oeps-tech/FED3-tester/PCB/tester/manufacturing/bom/FED3 tester BOM-additional.csv

# | Qty | Description | OEPSPN | MPN
1 | 18 | SPRING PROBE SLEEVE | OEPS100081 | S25-512
