oeps-tech/FED3-tester/3D/v1.0/Fed3Tester1.0.FCStd

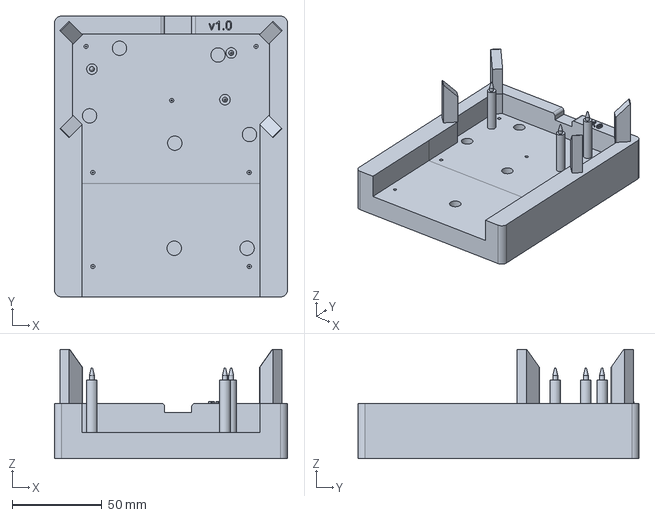
[picture p1: CAD file, 2026-05-28]
3D/v1.0/Fed3Tester1.0.FCStd
129.7 x 156.3 x 60.8 mm
