oeps-tech/FED3-tester/(list of files, cad)

Other CAD files:
3D/v1.0/manufacturing/Fed3Tester1.0-Body.stl
