oeps-tech/FED3-tester/Firmware/Fed3Tester/registers.xls

Sheet: registers
Has event. | When | Type | Array | Array Len. | Register Name | Desciption | Mask Type | Value | Name | Desciption
no |  | U16 | no |  | SWITCHES | Controls the switches like they were pressed in the physical board | bit | (1<<0) | START
 |  |  |  |  |  |  | bit | (1<<1) | PROG_OK
 |  |  |  |  |  |  | bit | (1<<2) | PROG_NOK
 |  |  |  |  |  |  | bit | (1<<3) | RGB_OK
 |  |  |  |  |  |  | bit | (1<<4) | RGB_NOK
 |  |  |  |  |  |  | bit | (1<<5) | MOTOR_OK
 |  |  |  |  |  |  | bit | (1<<6) | MOTOR_NOK
 |  |  |  |  |  |  | bit | (1<<7) | BUZZER_OK
 |  |  |  |  |  |  | bit | (1<<8) | BUZZER_NOK
yes | Every 100 ms | FLOAT | yes | 14 | READINGS | V_Vbat, V_VccRgb, V_3V3, V_LedCharge, V_LedRed, V_LedGreen, I_Vbat, SW_Start, SW_Prog, SW_Rgb, SW_Motor, SW_Buzzer, CurentState, PassFail
no |  | U16 | no |  | CONTROL | Controls internal signals | bit | (1<<0) | EN_VUSB_TO_DUT
no |  | U16 | no |  | CONTROL_SET | Controls internal signals | bit | (1<<1) | EN_3V7_TO_VBAT
no |  | U16 | no |  | CONTROL_CLEAR | Controls internal signals | bit | (1<<2) | EN_DUT_LDO_MODE
 |  |  |  |  |  |  | bit | (1<<3) | SELECT_VBAT_CURR_HIGH
 |  |  |  |  |  |  | bit | (1<<4) | EN_DUT_3V3_LDO
 |  |  |  |  |  |  | bit | (1<<5) | LED_3V3_AND_VBAT
 |  |  |  |  |  |  | bit | (1<<6) | LED_CURRENT
 |  |  |  |  |  |  | bit | (1<<7) | LED_LEDS
 |  |  |  |  |  |  | bit | (1<<8) | LED_VCC_RGB
 |  |  |  |  |  |  | bit | (1<<9) | LED_PASS
 |  |  |  |  |  |  | bit | (1<<10) | LED_FAIL
 |  |  |  |  |  |  | bit | (1<<11) | SOUND_WAIT_FOR_BUTTON
 |  |  |  |  |  |  | bit | (1<<12) | SOUND_PASS
 |  |  |  |  |  |  | bit | (1<<13) | SOUND_FAIL

Sheet: meta data
who am I: | 0
firmware major version: | 0
firmware minor version: | 1
hardware major version: | 2
hardware minor version: | 0
assembly version: | 0
device name: | Fed3Tester

Sheet: ios
Pin Name | PORT | Pin | Direction | Use Input | Out | Out default | Pull | Sense | Int. priority | Int. number | Desciption | Neg. Output
SW_START | PORTD | 0 | input |  |  |  | up | both_edges | off
SW_PROG_OK | PORTD | 1 | input |  |  |  | up | both_edges | off
SW_PROG_NOK | PORTD | 2 | input |  |  |  | up | both_edges | off
SW_MOTOR_OK | PORTD | 3 | input |  |  |  | up | both_edges | off
SW_MOTOR_NOK | PORTD | 4 | input |  |  |  | up | both_edges | off
SW_RGB_OK | PORTD | 5 | input |  |  |  | up | both_edges | off
SW_RGB_NOK | PORTD | 6 | input |  |  |  | up | both_edges | off
SW_BUZZER_OK | PORTD | 7 | input |  |  |  | up | both_edges | off
SW_BUZZER_NOK | PORTA | 0 | input |  |  |  | up | both_edges | off
LED_3V3_AND_VBAT | PORTC | 0 | output | yes | digital | 0 |  |  |  |  |  | no
LED_CURRENT | PORTC | 1 | output | yes | digital | 0 |  |  |  |  |  | no
LED_LEDS | PORTC | 2 | output | yes | digital | 0 |  |  |  |  |  | no
LED_VCC_RGB | PORTC | 3 | output | yes | digital | 0 |  |  |  |  |  | no
LED_PASS | PORTC | 5 | output | yes | digital | 0 |  |  |  |  |  | no
LED_FAIL | PORTC | 6 | output | yes | digital | 0 |  |  |  |  |  | no
EN_VUSB_TO_DUT | PORTC | 4 | output | yes | digital | 0 |  |  |  |  |  | no
BUZZER | PORTC | 7 | output | yes | digital | 0 |  |  |  |  |  | no
EN_3V7_TO_VBAT | PORTB | 0 | output | yes | digital | 0 |  |  |  |  |  | no
EN_DUT_LDO_MODE | PORTB | 1 | output | yes | digital | 0 |  |  |  |  |  | yes
SELECT_VBAT_CURR_HIGH | PORTB | 2 | output | yes | digital | 1 |  |  |  |  |  | yes
EN_DUT_3V3_LDO | PORTB | 3 | output | yes | digital | 0 |  |  |  |  |  | no

Sheet: options
Array | Type | Array | Bits type | Type | Mask Type | Direction | Use input | Pull | Sense | Int. priority | Int. number | Int. Mask | Out | Neg. Output
 |  |  |  | U8 | group_mask | input | yes | up | both_edges | low | 0 |  | digital | yes
yes | U8 | yes | bit | U16 | mask | output | no | down | rising_edge | med | 1 |  | wire_or | no
no | U16 | no | mask | U32 | bit |  |  | tristate | falling_edge | high |  |  | wire_and
 | U32 |  | group_mask | U64 |  |  |  | busholder | low_level | off |  |  | wired_or_pull
 | U64 |  |  | I8 |  |  |  |  | no_interrupt |  |  |  | wired_and_pull
 | I8 |  |  | I16
 | I16 |  |  | I32
 | I32 |  |  | I64
 | I64 |  |  | FLOAT
 | FLOAT
