oeps-tech/FED3-tester/PCB/tester/FED3 tester.kicad_pcb

## KiCad design PCB/tester/FED3 tester.kicad_pcb (2026-06-15)

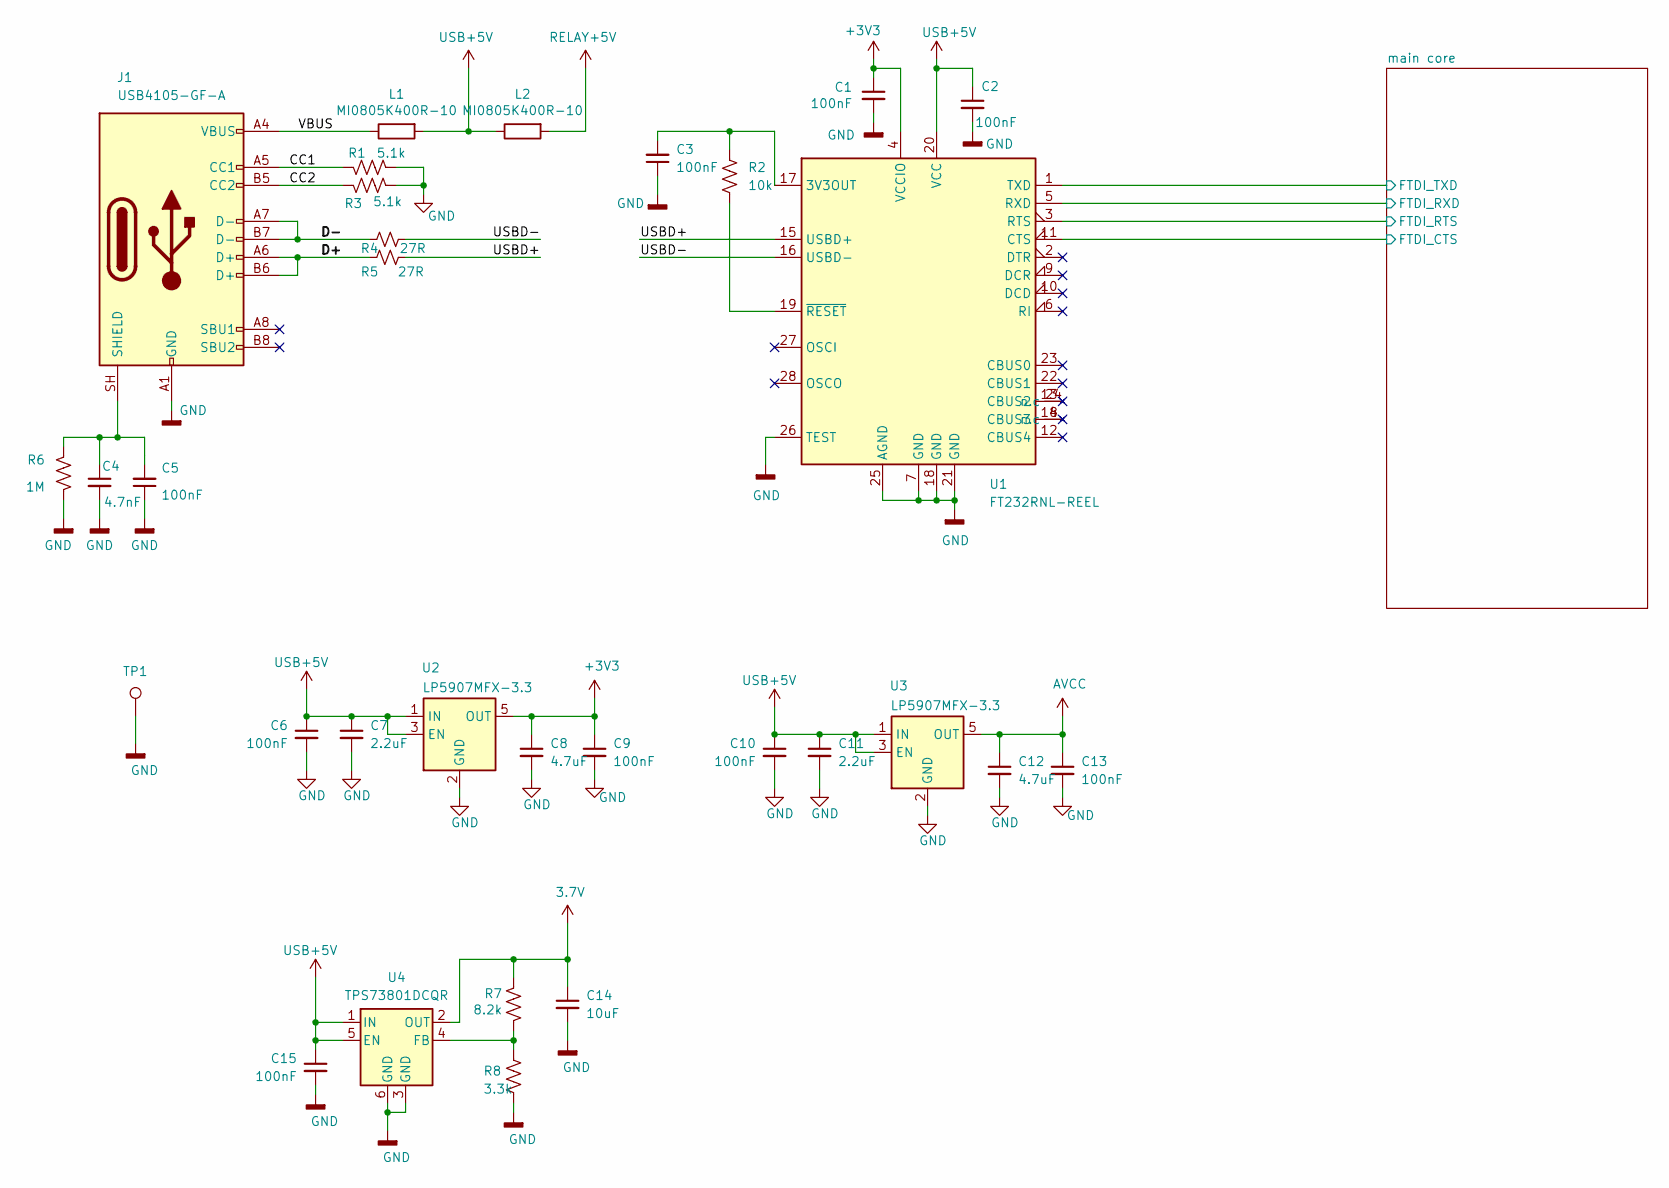
[picture p2: schematic FED3 tester.kicad_sch, FED3 Test Board]

Parts:
C1, C2, C3, C5, C6, C9, C10, C13, C15: 100nF; C_0402_1005Metric; Tolerance 10%; Voltage 50V; MPN CGA2B3X7R1H104K050BB
C4: 4.7nF; C_0402_1005Metric; Tolerance 10%; Voltage 100V; MPN 885012205084
C7, C11: 2.2uF; C_0603_1608Metric; Tolerance 10%; Voltage 25V; MPN GRM188R61E225KA12D
C8, C12: 4.7uF; C_0603_1608Metric; Tolerance 10%; Voltage 16V; MPN C1608X6S1C475K080AC
C14: 10uF; C_1206_3216Metric; Tolerance 10%; Voltage 25V; MPN GRM31CR71E106KA12L
J1: USB4105-GF-A; USB_C_Receptacle_GCT_USB4105-xx-A_16P_TopMnt_Horizontal; MPN USB4105-GF-A
L1, L2: MI0805K400R-10; R_0805_2012Metric; MPN MI0805K400R-10
R1, R3: 5.1k; R_0402_1005Metric; Tolerance 0.1%; MPN RT0402BRD075K1L
R2: 10k; R_0402_1005Metric; Tolerance 0.1%; MPN CPF0402B10KE1
R4, R5: 27R; R_0402_1005Metric; Tolerance 1%; MPN RMCF0402FT27R0
R6: 1M; R_0402_1005Metric; Tolerance 1%; MPN CRCW04021M00FKED
R7: 8.2k; R_0603_1608Metric; Tolerance 1%; MPN ERJ-3EKF8201V
R8: 3.3k; R_0402_1005Metric; Tolerance 1%; MPN ERJ-2RKF3301X
TP1: GND; PinHeader_1x01_P2.54mm_Vertical; MPN n.a
U1: FT232RNL-REEL; SSOP-28_5.3x10.2mm_P0.65mm; MPN FT232RNL-REEL
U2, U3: LP5907MFX-3.3; SOT-23-5; MPN LP5907MFX-3.3/NOPB
U4: TPS73801DCQR; SOT-223-6; MPN TPS73801DCQR

Connections:
3.7V: C14.1, R7.2, U4.2 (OUT); also elsewhere on the board
+3V3: C1.1, C8.1, C9.1, U1.4 (VCCIO), U2.5 (OUT); also elsewhere on the board
/CC1: J1.A5 (CC1), R1.1
/CC2: J1.B5 (CC2), R3.1
/D+: J1.A6 (D+), J1.B6 (D+), R5.2
/D-: J1.A7 (D-), J1.B7 (D-), R4.2
/USBD+: R5.1, U1.15 (USBD+)
/USBD-: R4.1, U1.16 (USBD-)
/VBUS: J1.A4 (VBUS), J1.A9 (VBUS), J1.B4 (VBUS), J1.B9 (VBUS), L1.1
/main core/FTDI_CTS: U1.11 (CTS); also elsewhere on the board
/main core/FTDI_RTS: U1.3 (RTS); also elsewhere on the board
/main core/FTDI_RXD: U1.5 (RXD); also elsewhere on the board
/main core/FTDI_TXD: U1.1 (TXD); also elsewhere on the board
AVCC: C12.1, C13.1, U3.5 (OUT); also elsewhere on the board
GND: C1.2, C2.2, C3.1, C4.2, C5.1, C6.2, C7.2, C8.2, C9.2, C10.2, C11.2, C12.2, C13.2, C14.2, C15.2, J1.A1 (GND), J1.A12 (GND), J1.B1 (GND), J1.B12 (GND), R1.2, R3.2, R6.1, R8.1, TP1.1 (1_1), U1.7 (GND), U1.18 (GND), U1.21 (GND), U1.25 (AGND), U1.26 (TEST), U2.2 (GND), U3.2 (GND), U4.3 (GND), U4.6 (GND); also elsewhere on the board
unnamed: C4.1, C5.2, J1.SH (SHIELD), R6.2
unnamed: C3.2, R2.1, U1.17 (3V3OUT)
unnamed: R2.2, U1.19 (~RESET)
unnamed: R7.1, R8.2, U4.4 (FB)
RELAY+5V: L2.2; also elsewhere on the board
USB+5V: C2.1, C6.1, C7.1, C10.1, C11.1, C15.1, L1.2, L2.1, U1.20 (VCC), U2.1 (IN), U2.3 (EN), U3.1 (IN), U3.3 (EN), U4.1 (IN), U4.5 (EN); also elsewhere on the board

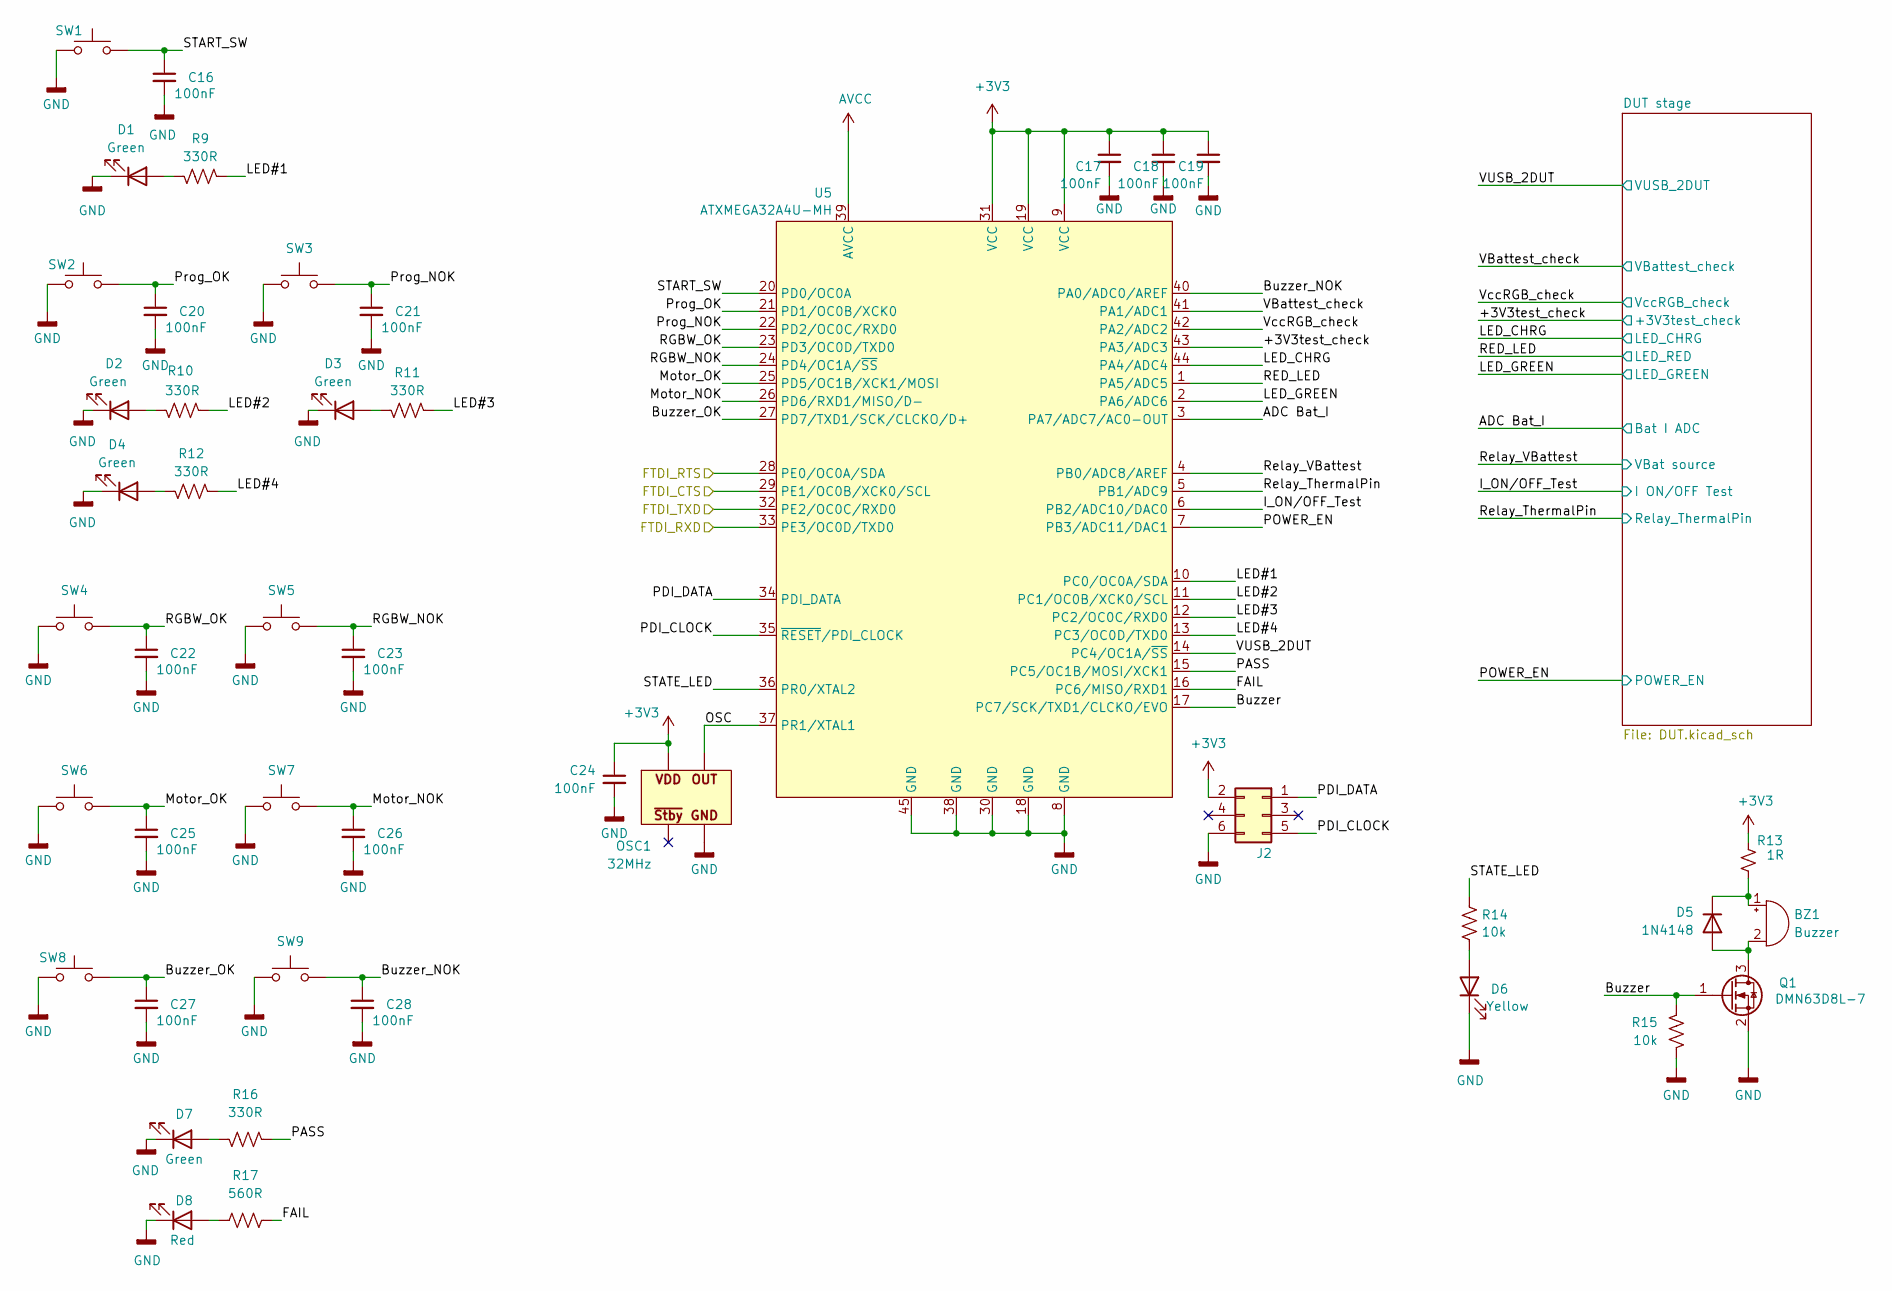
[picture p3: schematic main core.kicad_sch]

Parts:
BZ1: Buzzer; SMT-0540-T-9-R Buzzer; Voltage 3V; MPN CSS-0575A-SMT-TR
C16, C17, C18, C19, C20, C21, C22, C23, C24, C25, C26, C27, C28: 100nF; C_0402_1005Metric; Tolerance 10%; Voltage 50V; MPN CGA2B3X7R1H104K050BB
D1, D2, D3, D4, D7: Green; LED_0603_1608Metric; MPN LTST-C191KGKT
D5: 1N4148; D_SOD-123; MPN 1N4148WS-E3-18
D6: Yellow; LED_0603_1608Metric; MPN 5990040007F
D8: Red; LED_0603_1608Metric; MPN 5990010007F
J2: PR20203VBDN; PinHeader_2x03_P2.54mm_Vertical; MPN PR20203VBDN
OSC1: 32MHz; OSC; MPN DSC1001CI5-032.0000
Q1: DMN63D8L-7; SOT-23; MPN DMN63D8L-7
R9, R10, R11, R12, R16: 330R; R_0402_1005Metric; Tolerance 1%; MPN CRCW0402330RFKEDHP
R13: 1R; R_0402_1005Metric; Tolerance 1%; MPN CRCW04021R00FKEDHP
R14, R15: 10k; R_0402_1005Metric; Tolerance 0.1%; MPN CPF0402B10KE1
R17: 560R; R_0402_1005Metric; Tolerance 1%; MPN CRCW0402560RFKED
SW1, SW2, SW3, SW4, SW5, SW6, SW7, SW8, SW9: TL3305BF260QG; SW_SPST_TL3305B; MPN TL3305BF260QG
U5: ATXMEGA32A4U-MH; QFN-44-1EP_7x7mm_P0.5mm_EP5.2x5.2mm; MPN ATXMEGA32A4U-MHR

Connections:
+3V3: C17.1, C18.1, C19.1, C24.1, J2.2, OSC1.4 (VDD), R13.1, U5.9 (VCC), U5.19 (VCC), U5.31 (VCC); also elsewhere on the board
/main core/+3V3test_check: U5.43 (PA3/ADC3); also elsewhere on the board
/main core/ADC Bat_I: U5.3 (PA7/ADC7/AC0-OUT); also elsewhere on the board
/main core/Buzzer: Q1.1 (G), R15.2, U5.17 (PC7/SCK/TXD1/CLCKO/EVO)
/main core/Buzzer_NOK: C28.1, SW9.2, U5.40 (PA0/ADC0/AREF)
/main core/Buzzer_OK: C27.1, SW8.2, U5.27 (PD7/TXD1/SCK/CLCKO/D+)
/main core/FAIL: R17.2, U5.16 (PC6/MISO/RXD1)
/main core/FTDI_CTS: U5.29 (PE1/OC0B/XCK0/SCL); also elsewhere on the board
/main core/FTDI_RTS: U5.28 (PE0/OC0A/SDA); also elsewhere on the board
/main core/FTDI_RXD: U5.33 (PE3/OC0D/TXD0); also elsewhere on the board
/main core/FTDI_TXD: U5.32 (PE2/OC0C/RXD0); also elsewhere on the board
/main core/I_ON/OFF_Test: U5.6 (PB2/ADC10/DAC0); also elsewhere on the board
/main core/LED#1: R9.2, U5.10 (PC0/OC0A/SDA)
/main core/LED#2: R10.2, U5.11 (PC1/OC0B/XCK0/SCL)
/main core/LED#3: R11.2, U5.12 (PC2/OC0C/RXD0)
/main core/LED#4: R12.2, U5.13 (PC3/OC0D/TXD0)
/main core/LED_CHRG: U5.44 (PA4/ADC4); also elsewhere on the board
/main core/LED_GREEN: U5.2 (PA6/ADC6); also elsewhere on the board
/main core/Motor_NOK: C26.1, SW7.2, U5.26 (PD6/RXD1/MISO/D-)
/main core/Motor_OK: C25.1, SW6.2, U5.25 (PD5/OC1B/XCK1/MOSI)
/main core/OSC: OSC1.3 (OUT), U5.37 (PR1/XTAL1)
/main core/PASS: R16.2, U5.15 (PC5/OC1B/MOSI/XCK1)
/main core/PDI_CLOCK: J2.5, U5.35 (~RESET/PDI_CLOCK)
/main core/PDI_DATA: J2.1, U5.34 (PDI_DATA)
/main core/POWER_EN: U5.7 (PB3/ADC11/DAC1); also elsewhere on the board
/main core/Prog_NOK: C21.1, SW3.2, U5.22 (PD2/OC0C/RXD0)
/main core/Prog_OK: C20.1, SW2.2, U5.21 (PD1/OC0B/XCK0)
/main core/RED_LED: U5.1 (PA5/ADC5); also elsewhere on the board
/main core/RGBW_NOK: C23.1, SW5.2, U5.24 (PD4/OC1A/~SS)
/main core/RGBW_OK: C22.1, SW4.2, U5.23 (PD3/OC0D/TXD0)
/main core/Relay_ThermalPin: U5.5 (PB1/ADC9); also elsewhere on the board
/main core/Relay_VBattest: U5.4 (PB0/ADC8/AREF); also elsewhere on the board
/main core/START_SW: C16.1, SW1.2, U5.20 (PD0/OC0A)
/main core/STATE_LED: R14.2, U5.36 (PR0/XTAL2)
/main core/VBattest_check: U5.41 (PA1/ADC1); also elsewhere on the board
/main core/VUSB_2DUT: U5.14 (PC4/OC1A/~SS); also elsewhere on the board
/main core/VccRGB_check: U5.42 (PA2/ADC2); also elsewhere on the board
AVCC: U5.39 (AVCC); also elsewhere on the board
GND: C16.2, C17.2, C18.2, C19.2, C20.2, C21.2, C22.2, C23.2, C24.2, C25.2, C26.2, C27.2, C28.2, D1.1 (K), D2.1 (K), D3.1 (K), D4.1 (K), D6.1 (K), D7.1 (K), D8.1 (K), J2.6, OSC1.2 (GND), Q1.2 (S), R15.1, SW1.1, SW2.1, SW3.1, SW4.1, SW5.1, SW6.1, SW7.1, SW8.1, SW9.1, U5.8 (GND), U5.18 (GND), U5.30 (GND), U5.38 (GND), U5.45 (GND); also elsewhere on the board
unnamed: BZ1.1 (+), D5.1 (K), R13.2
unnamed: BZ1.2 (-), D5.2 (A), Q1.3 (D)
unnamed: D1.2 (A), R9.1
unnamed: D2.2 (A), R10.1
unnamed: D3.2 (A), R11.1
unnamed: D4.2 (A), R12.1
unnamed: D6.2 (A), R14.1
unnamed: D7.2 (A), R16.1
unnamed: D8.2 (A), R17.1

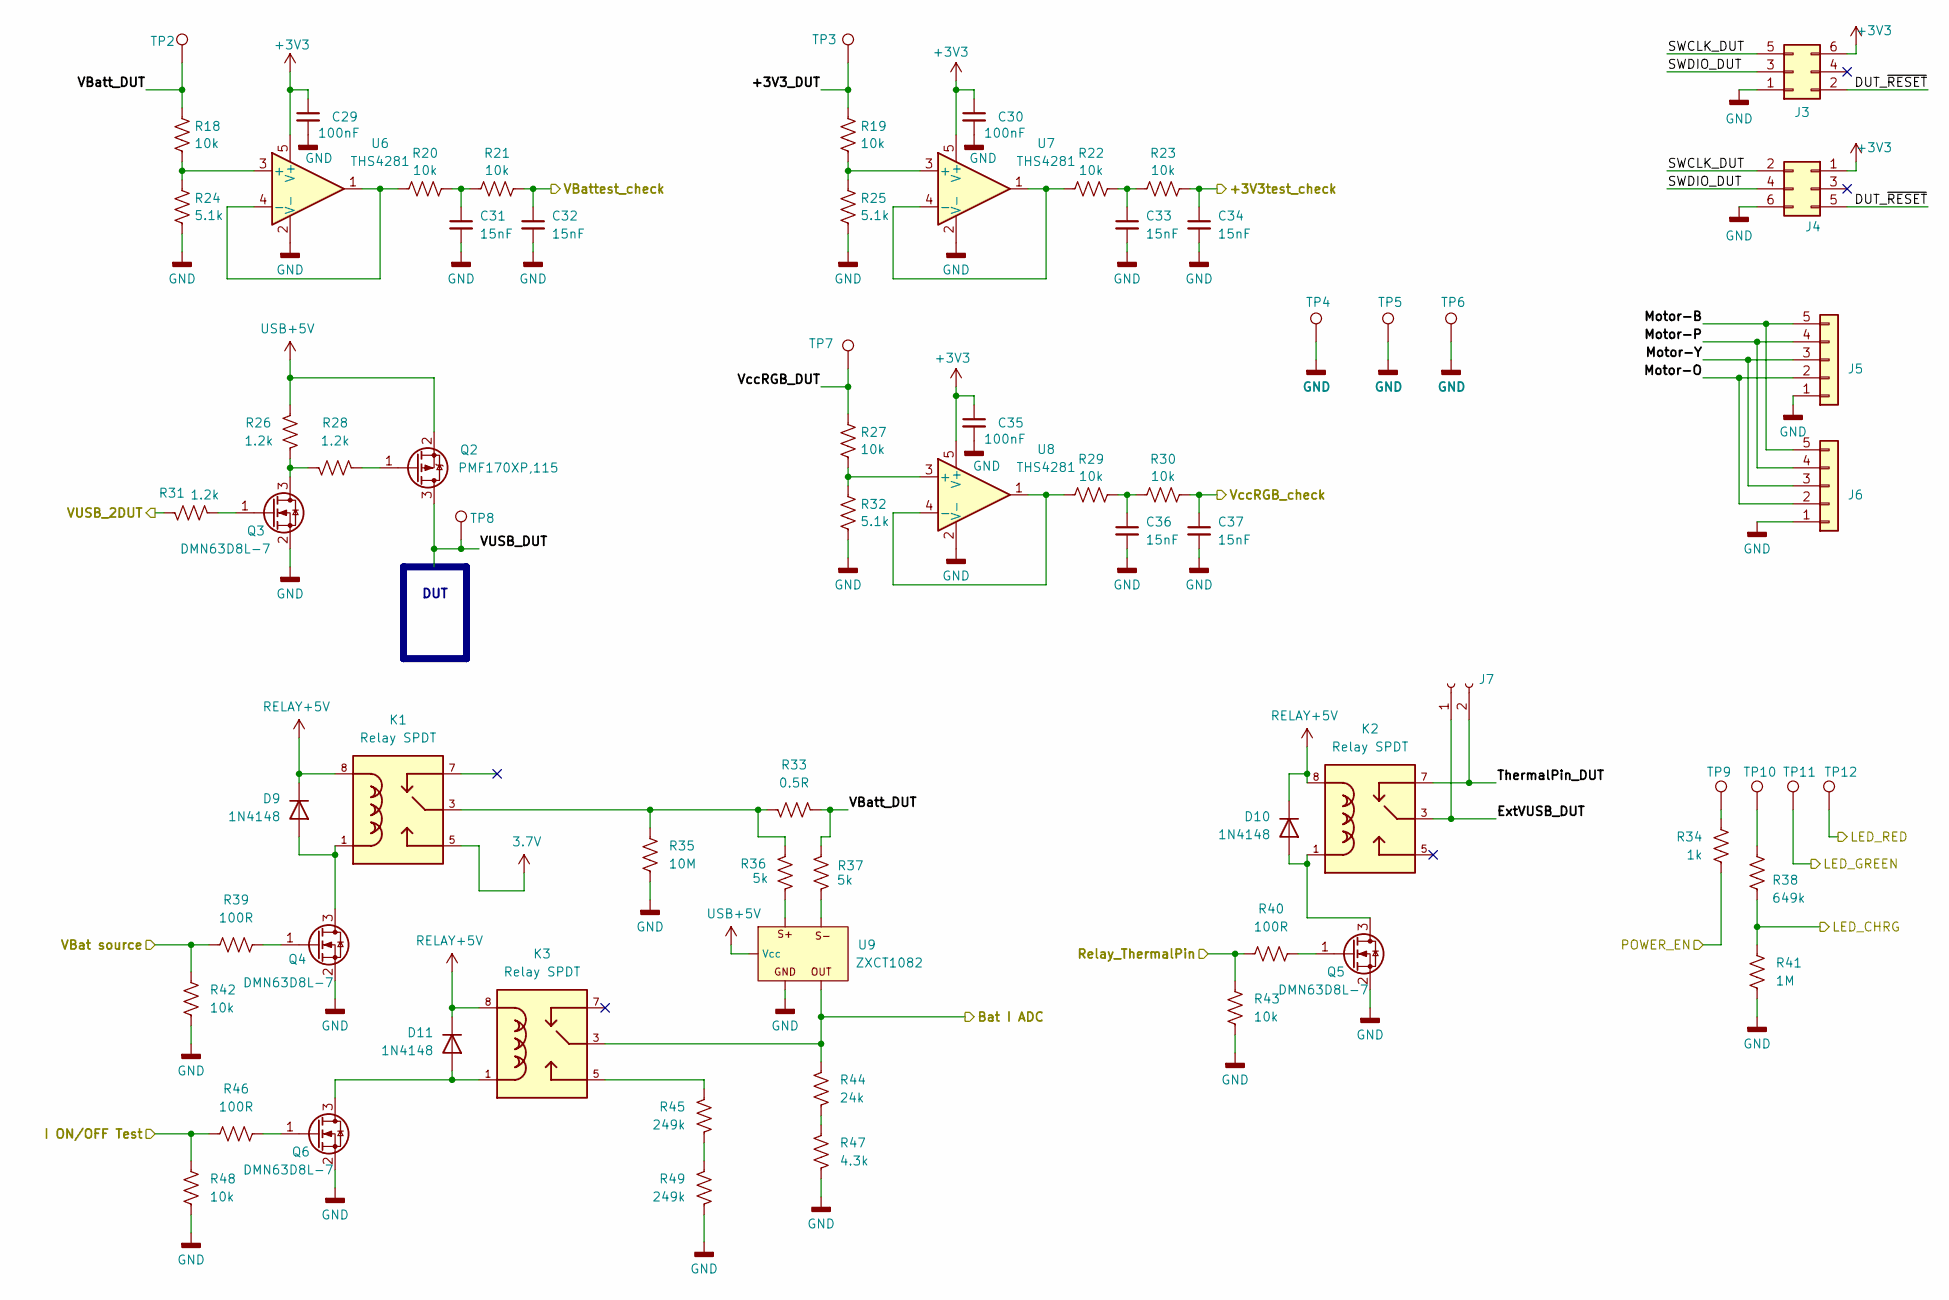
[picture p4: schematic DUT.kicad_sch]

Parts:
C29, C30, C35: 100nF; C_0402_1005Metric; Tolerance 10%; Voltage 50V; MPN CGA2B3X7R1H104K050BB
C31, C32, C33, C34, C36, C37: 15nF; C_0402_1005Metric; Tolerance 10%; Voltage 35V; MPN CGA2B3X7R1V153K050BB
D9, D10, D11: 1N4148; D_SOD-123; MPN 1N4148WS-E3-18
J3: 6pin_hd; PinHeader_2x03_to Probes; MPN n.a
J4: 61300621021; PinHeader_2x03_P2.54mm_Horizontal; MPN 61300621021
J5: PPTC051LFBN-RC; PinSocket_1x05_P2.54mm_Vertical; MPN PPTC051LFBN-RC
J6: 61300511021; PinSocket_1x05_P2.54mm_Horizontal; MPN 61300511021
J7: PPTC021LFBN-RC; PinSocket_1x02_P2.54mm_Vertical; MPN PPTC021LFBN-RC
K1, K2, K3: Relay SPDT; RELAY_1462042-8; MPN 1462042-8
Q2: PMF170XP,115; SOT-323_SC-70; MPN PMF170XP,115
Q3, Q4, Q5, Q6: DMN63D8L-7; SOT-23; MPN DMN63D8L-7
R18, R19, R20, R21, R22, R23, R27, R29, R30, R42, R43, R48: 10k; R_0402_1005Metric; Tolerance 0.1%; MPN CPF0402B10KE1
R24, R25, R32: 5.1k; R_0402_1005Metric; Tolerance 0.1%; MPN RT0402BRD075K1L
R26, R28, R31: 1.2k; R_0402_1005Metric; Tolerance 0.1%; MPN ERA-2AEB122X
R33: 0.5R; R_0805_2012Metric; Tolerance 1%; MPN RL1220S-R50-F
R34: 1k; R_0402_1005Metric; Tolerance 1%; MPN CRCW04021K00FKED
R35: 10M; R_0402_1005Metric; Tolerance 1%; MPN CRCW040210M0FKED
R36, R37: 5k; R_0402_1005Metric; Tolerance 0.1%; MPN PNM0402E5001BST1
R38: 649k; R_0402_1005Metric; Tolerance 1%; MPN ERJ-2RKF6493X
R39, R40, R46: 100R; R_0402_1005Metric; Tolerance 1%; MPN RCS0402100RFKED
R41: 1M; R_0402_1005Metric; Tolerance 1%; MPN CRCW04021M00FKED
R44: 24k; R_0402_1005Metric; Tolerance 1%; MPN ERJ-2RKF2402X
R45, R49: 249k; R_0402_1005Metric; Tolerance 1%; MPN RMCF0402FT249K
R47: 4.3k; R_0603_1608Metric; Tolerance 5%; MPN ERJ-3GEYJ432V
TP2: VBattest; Pin_D1.75mm; MPN n.a
TP3: +3V3test; Pin_D1.75mm; MPN n.a
TP4, TP5, TP6, TP9, TP10, TP11, TP12: GND; Pin_D1.75mm; MPN n.a
TP7: VccRGB; Pin_D1.75mm; MPN n.a
TP8: VUSBtest; Pin_D1.75mm; MPN n.a
U6, U7, U8: THS4281; SOT-23-5; MPN THS4281DBVT
U9: ZXCT1082; SOT-23-5; MPN ZXCT1082QE5TA

Connections:
3.7V: K1.5; also elsewhere on the board
+3V3: C29.1, C30.1, C35.1, J3.6, J4.1, U6.5 (V+), U7.5 (V+), U8.5 (V+); also elsewhere on the board
/main core/+3V3test_check: C34.1, R23.2; also elsewhere on the board
/main core/ADC Bat_I: K3.3, R44.1, U9.1 (OUT); also elsewhere on the board
/main core/DUT stage/+3V3_DUT: R19.2, TP3.1 (1_1)
/main core/DUT stage/DUT_~RESET: J3.2, J4.5
/main core/DUT stage/ExtVUSB_DUT: J7.1, K2.3
/main core/DUT stage/Motor-B: J5.5, J6.5
/main core/DUT stage/Motor-O: J5.2, J6.2
/main core/DUT stage/Motor-P: J5.4, J6.4
/main core/DUT stage/Motor-Y: J5.3, J6.3
/main core/DUT stage/SWCLK_DUT: J3.5, J4.2
/main core/DUT stage/SWDIO_DUT: J3.3, J4.4
/main core/DUT stage/ThermalPin_DUT: J7.2, K2.7
/main core/DUT stage/VBatt_DUT: R18.2, R33.2, R37.2, TP2.1 (1_1)
/main core/DUT stage/VUSB_DUT: Q2.3 (D), TP8.1 (1_1)
/main core/DUT stage/VccRGB_DUT: R27.2, TP7.1 (1_1)
/main core/I_ON/OFF_Test: R46.1, R48.2; also elsewhere on the board
/main core/LED_CHRG: R38.1, R41.2; also elsewhere on the board
/main core/LED_GREEN: TP11.1 (1_1); also elsewhere on the board
/main core/POWER_EN: R34.1; also elsewhere on the board
/main core/RED_LED: TP12.1 (1_1); also elsewhere on the board
/main core/Relay_ThermalPin: R40.1, R43.2; also elsewhere on the board
/main core/Relay_VBattest: R39.1, R42.2; also elsewhere on the board
/main core/VBattest_check: C32.1, R21.2; also elsewhere on the board
/main core/VUSB_2DUT: R31.2; also elsewhere on the board
/main core/VccRGB_check: C37.1, R30.2; also elsewhere on the board
GND: C29.2, C30.2, C31.2, C32.2, C33.2, C34.2, C35.2, C36.2, C37.2, J3.1, J4.6, J5.1, J6.1, Q3.2 (S), Q4.2 (S), Q5.2 (S), Q6.2 (S), R24.1, R25.1, R32.1, R35.1, R41.1, R42.1, R43.1, R47.2, R48.1, R49.1, TP4.1 (1_1), TP5.1 (1_1), TP6.1 (1_1), U6.2 (V-), U7.2 (V-), U8.2 (V-), U9.2 (GND); also elsewhere on the board
unnamed: C31.1, R20.2, R21.1
unnamed: C33.1, R22.2, R23.1
unnamed: C36.1, R29.2, R30.1
unnamed: D9.2 (A), K1.1, Q4.3 (D)
unnamed: D10.2 (A), K2.1, Q5.3 (D)
unnamed: D11.2 (A), K3.1, Q6.3 (D)
unnamed: K1.3, R33.1, R35.2, R36.2
unnamed: K3.5, R45.2
unnamed: Q2.1 (G), R28.2
unnamed: Q3.3 (D), R26.1, R28.1
unnamed: Q3.1 (G), R31.1
unnamed: Q4.1 (G), R39.2
unnamed: Q5.1 (G), R40.2
unnamed: Q6.1 (G), R46.2
unnamed: R34.2, TP9.1 (1_1)
unnamed: R38.2, TP10.1 (1_1)
unnamed: R44.2, R47.1
unnamed: R45.1, R49.2
unnamed: R18.1, R24.2, U6.3 (+)
unnamed: R20.1, U6.1, U6.4 (-)
unnamed: R19.1, R25.2, U7.3 (+)
unnamed: R22.1, U7.1, U7.4 (-)
unnamed: R27.1, R32.2, U8.3 (+)
unnamed: R29.1, U8.1, U8.4 (-)
unnamed: R36.1, U9.3 (S+)
unnamed: R37.1, U9.4 (S-)
RELAY+5V: D9.1 (K), D10.1 (K), D11.1 (K), K1.8, K2.8, K3.8; also elsewhere on the board
USB+5V: Q2.2 (S), R26.2, U9.5 (Vcc); also elsewhere on the board

Notes on the sheet:
DUT

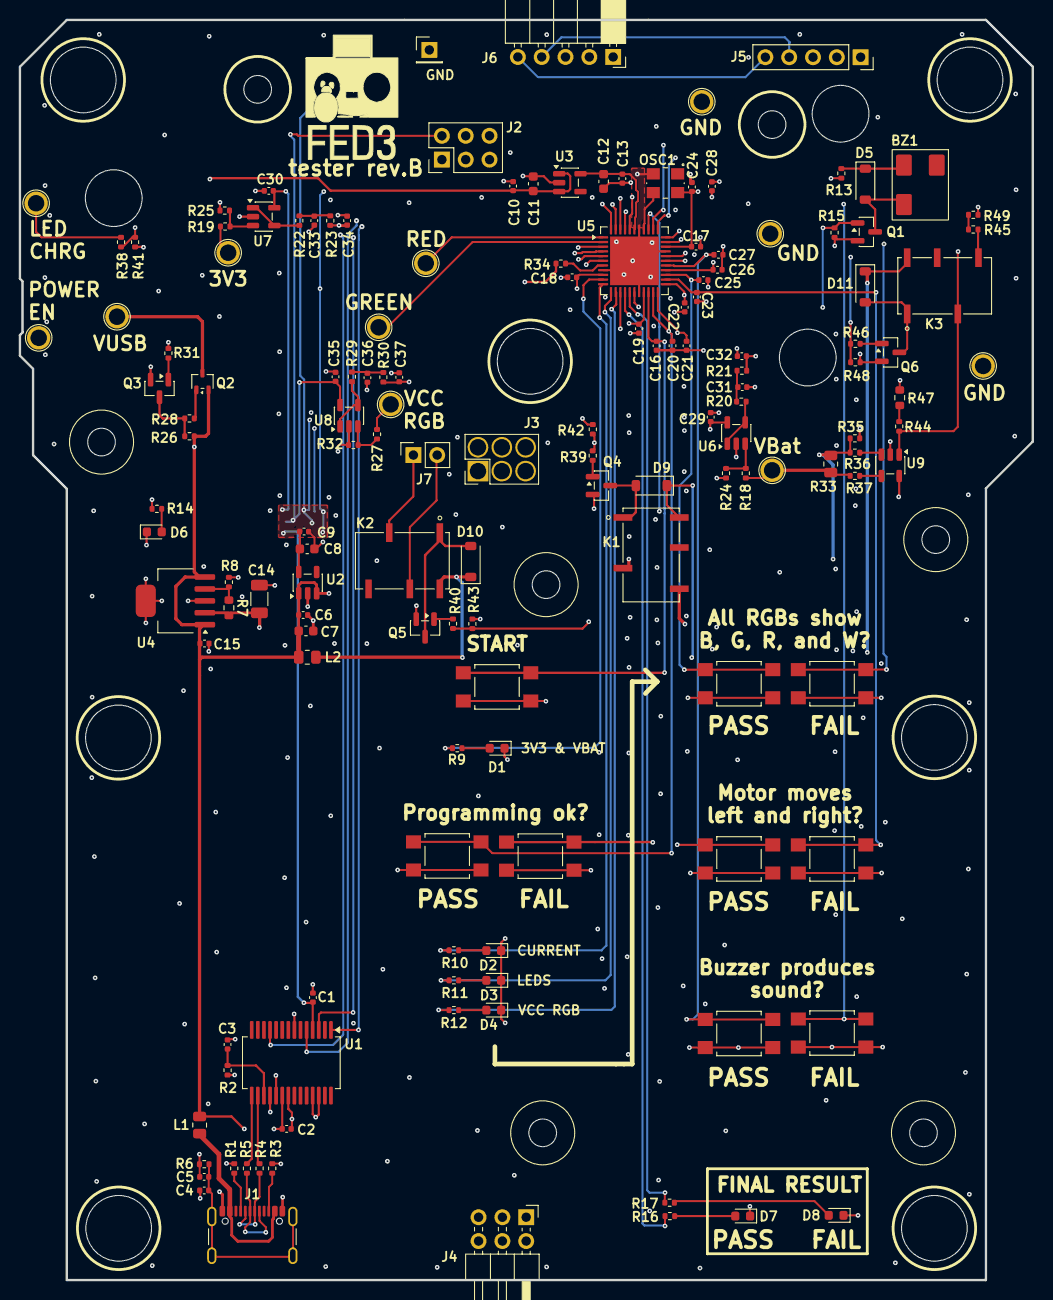
[picture p5: board FED3 tester.kicad_pcb from above]

Board: 4 copper layers, 108.0 x 134.4 mm, 155 parts (0 on the bottom side), 101 nets.

Other parts of the board:
@HOLE6, @HOLE6#2, @HOLE6#3: MechHole_6.05mm
Ref**: Val**; MechHole_2.95mm
Ref**#2, Ref**#3, Ref**#4, Ref**#5: Val**; MechHole_2.95mm
