oeps-tech/FED3-tester/(commit log)

2026-05-15 Final details and production files
    [DUT.kicad_sch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]
2026-05-15 Added addition al components
    [low-profile-headstage-64ch-3d BOM-additional.csv]
2026-05-22 Renamed BOM files
    [FED3 tester BOM-additional.csv, FED3 tester BOM.csv]
2026-05-28 Added the 3D design
    [Fed3Tester1.0-Body.stl, Fed3Tester1.0.FCStd]
2026-06-03 Update 1N4148 part numbers
    Replace obsolete 1N4148 :
    OEPS030017 -> OEPS030052
    1N4148WX-TP -> 1N4148WS-E3-18
    [DUT.kicad_sch, FED3 tester BOM.csv, FED3 tester.kicad_pcb, main core.kicad_sch]
2026-06-08 First firmware files
    [registers.xls]
2026-06-11 Add ADC filtering, buttons, sound & state logic
    [registers.xls]
2026-06-11 Refine analog reading comments and REG_READINGS
    [registers.xls]
2026-06-15 Replace R13 100R with 1R and update BOM/metadata
    [FED3 tester BOM.csv, FED3 tester.kicad_pcb, main core.kicad_sch]
2026-07-10 Implement complete FED3 tester state machine
    Implements the full 13-state test sequence for the FED3 device tester, including:
    - State machine with states for hardware initialization, power delivery, DUT testing, LED/motor/buzzer validation
    - Current measurement calibration with high/low range selection
    - Voltage measurements for VBAT, 3V3, VCC_RGB, and charge LED
    - LED and audio feedback for pass/fail indication
    - Inter-state interval timing for proper state transition handling
    - Updated ADC event reporting from 20ms to 10ms intervals
    - Inverted SELECT_VBAT_CURR_HIGH GPIO logic to match hardware behavior.
    [registers.xls]
2026-11-03 Widen battery current test limits
    Bump firmware to 1.1 and expand the accepted current range in test s6.
